BarkingTadpole/Hubba-Hubba-hub-motor-RC/README.md

car go vroom but with 4 hub motors and torque vectoring and maybe self driving eventually
