BarkingTadpole/Hubba-Hubba-hub-motor-RC/tools/esp32_pin_map/esp32_board_minimal.png

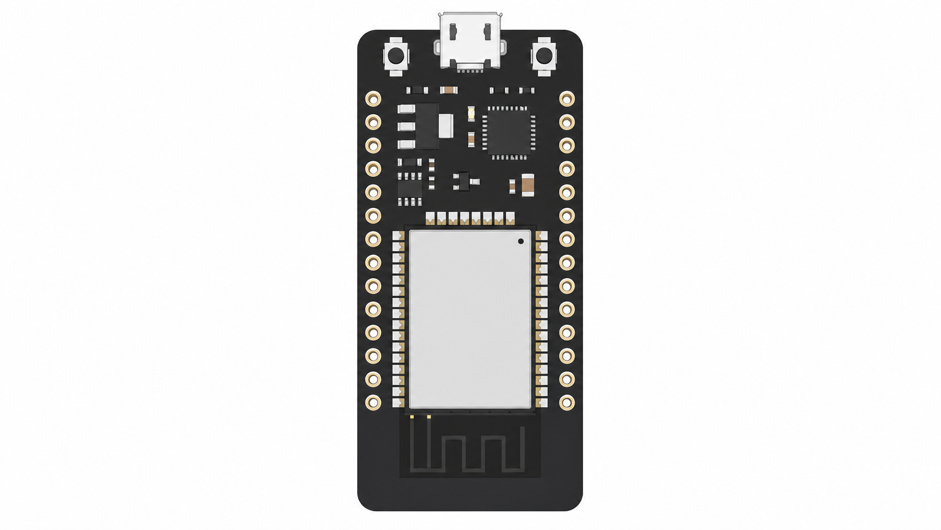
tools/esp32_pin_map/esp32_board_minimal.png
