BarkingTadpole/Hubba-Hubba-hub-motor-RC/rc_car_project_models/V2/attenuators/front_attenuator - front_attenuator.3mf

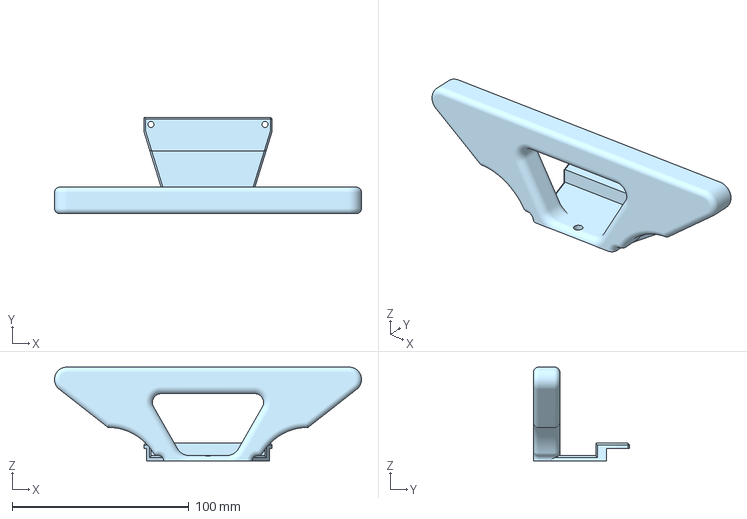
[picture p2: CAD file, 2026-07-19, last stored version]
rc_car_project_models/V2/attenuators/front_attenuator - front_attenuator.3mf
173.5 x 54.4 x 53.0 mm
