BarkingTadpole/Hubba-Hubba-hub-motor-RC/rc_car_project_models/V2/chassis/chassis_3dp_split - mid_body_rear.3mf

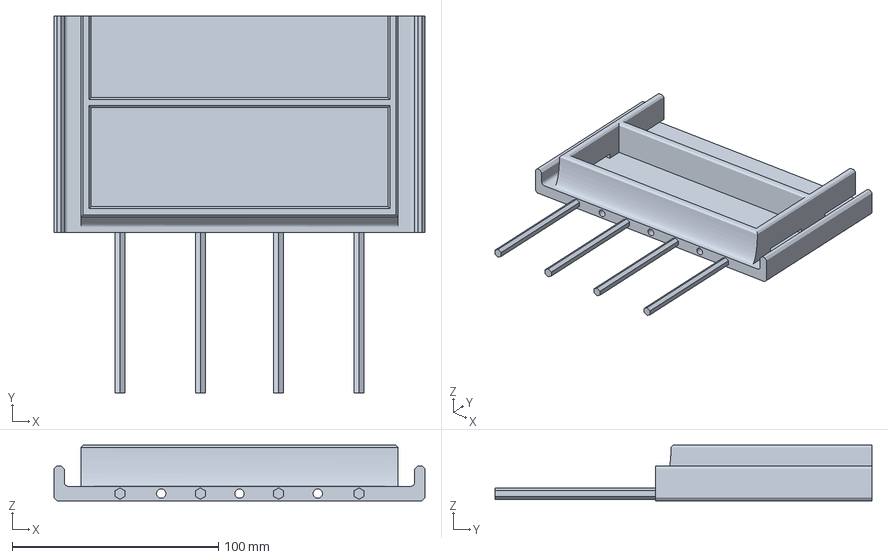
[picture p3: CAD file, 2026-07-19, last stored version]
rc_car_project_models/V2/chassis/chassis_3dp_split - mid_body_rear.3mf
180.0 x 183.0 x 27.0 mm
