BarkingTadpole/Hubba-Hubba-hub-motor-RC/rc_car_project_models/V2/shock_tower+steering+uprights_print.3mf

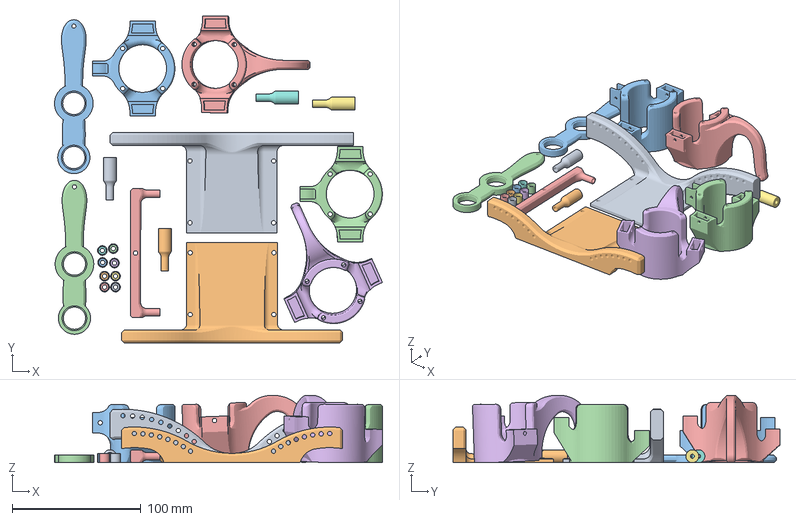
[picture p4: CAD file, 2026-07-19, last stored version]
rc_car_project_models/V2/shock_tower+steering+uprights_print.3mf
254.7 x 253.7 x 52.3 mm
rear_shock_tower
front_shock_tower
rear_left_upright
rear_right_upright
front_left_upright
front_right_upright
end_cap x 8
bellcrank_pivot x 4
bellcrank x 2
drag_link
