BarkingTadpole/Hubba-Hubba-hub-motor-RC/rc_car_project_models/V2/shock_towers/front_shock_tower - front_shock_tower.3mf

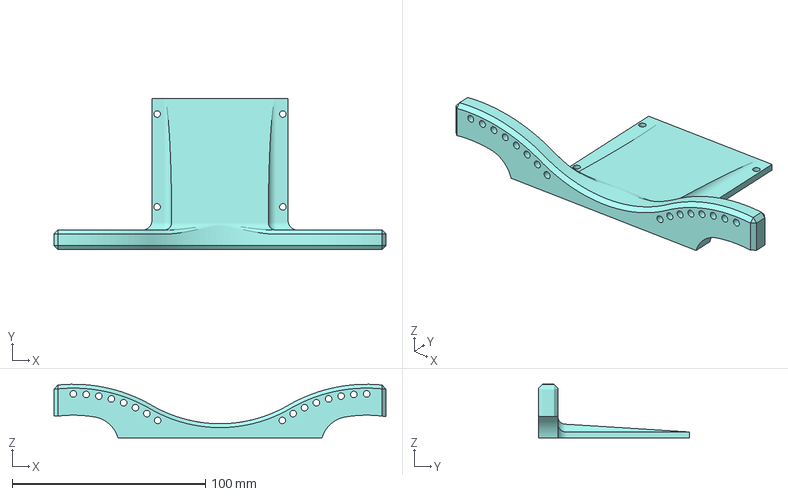
[picture p5: CAD file, 2026-07-19, last stored version]
rc_car_project_models/V2/shock_towers/front_shock_tower - front_shock_tower.3mf
171.6 x 78.0 x 27.7 mm
