BarkingTadpole/Hubba-Hubba-hub-motor-RC/rc_car_project_models/V2/steering/bellcrank - bellcrank.3mf

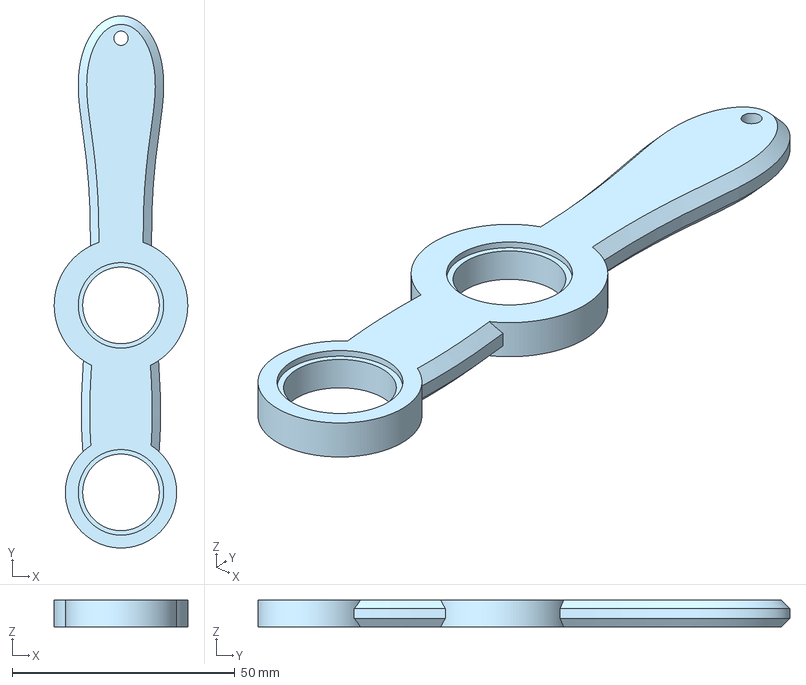
[picture p6: CAD file, 2026-07-19, last stored version]
rc_car_project_models/V2/steering/bellcrank - bellcrank.3mf
30.0 x 119.5 x 6.00 mm
