BarkingTadpole/Hubba-Hubba-hub-motor-RC/rc_car_project_models/V2/uprights/rear_uprights - rear_left_upright.3mf

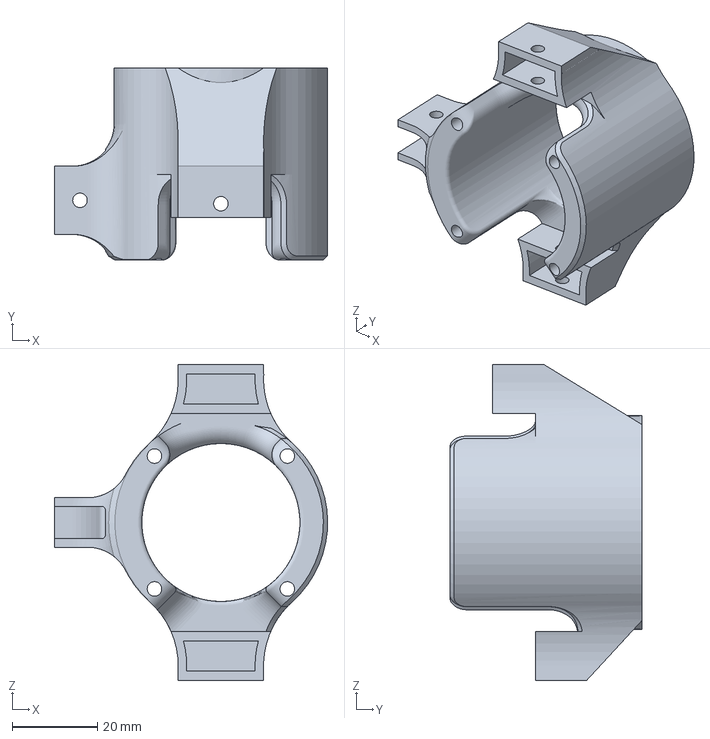
[picture p7: CAD file, 2026-07-19, last stored version]
rc_car_project_models/V2/uprights/rear_uprights - rear_left_upright.3mf
64.0 x 45.0 x 74.0 mm
