BarkingTadpole/Hubba-Hubba-hub-motor-RC/rc_car_project_models/V2/wishbones+spacers/upper_wishbone - upper_wishbone.3mf

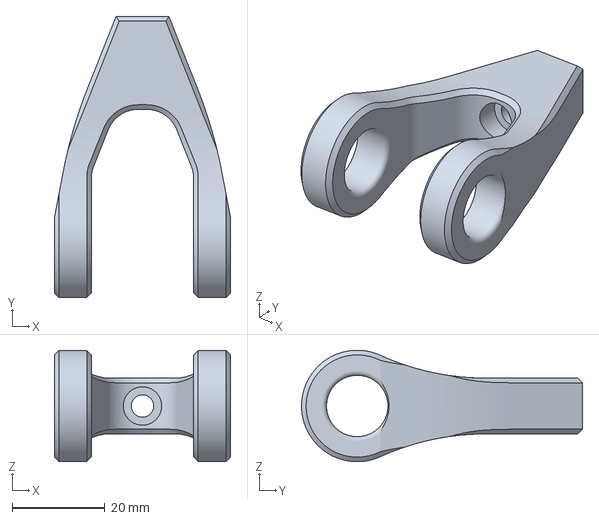
[picture p8: CAD file, 2026-07-19, last stored version]
rc_car_project_models/V2/wishbones+spacers/upper_wishbone - upper_wishbone.3mf
38.0 x 60.5 x 24.0 mm
