BarkingTadpole/Hubba-Hubba-hub-motor-RC/rc_car_project_models/V2/attenuators/rear_attenuator - rear_attenuator.3mf

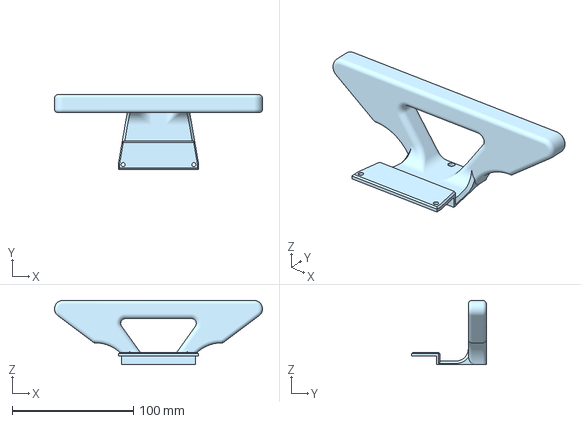
[picture p9: CAD file, 2026-07-19, last stored version]
rc_car_project_models/V2/attenuators/rear_attenuator - rear_attenuator.3mf
171.9 x 61.9 x 53.0 mm
