BarkingTadpole/Hubba-Hubba-hub-motor-RC/rc_car_project_models/V2/shock_towers/rear_shock_tower - rear_shock_tower.3mf

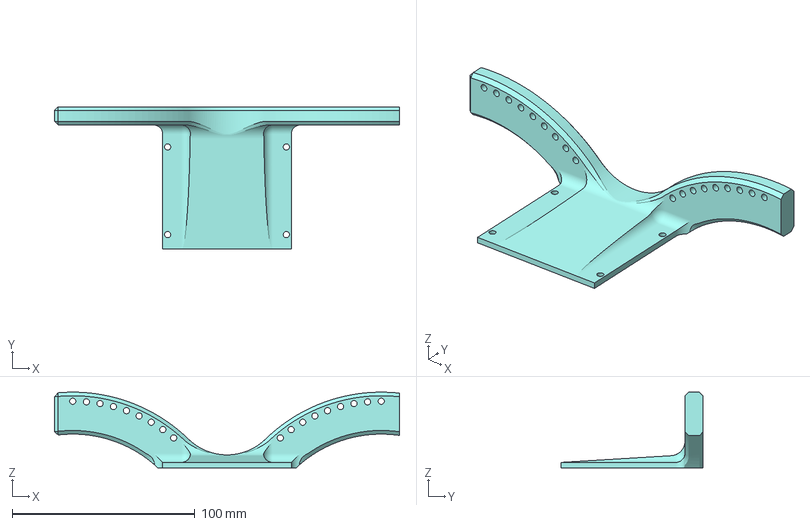
[picture p11: CAD file, 2026-07-19, last stored version]
rc_car_project_models/V2/shock_towers/rear_shock_tower - rear_shock_tower.3mf
189.0 x 78.0 x 41.5 mm
