BarkingTadpole/Hubba-Hubba-hub-motor-RC/rc_car_project_models/V2/steering/end_cap - end_cap.3mf

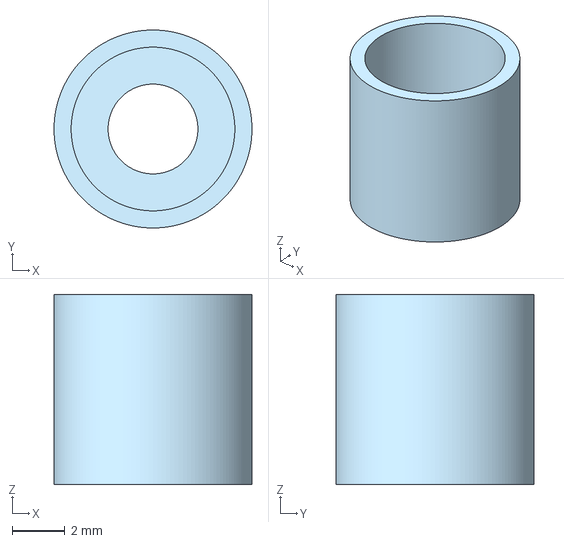
[picture p12: CAD file, 2026-07-19, last stored version]
rc_car_project_models/V2/steering/end_cap - end_cap.3mf
7.50 x 7.50 x 7.20 mm
