BarkingTadpole/Hubba-Hubba-hub-motor-RC/rc_car_project_models/V2/wishbones+spacers/shock_tower_spacer - shock_tower_spacer.3mf

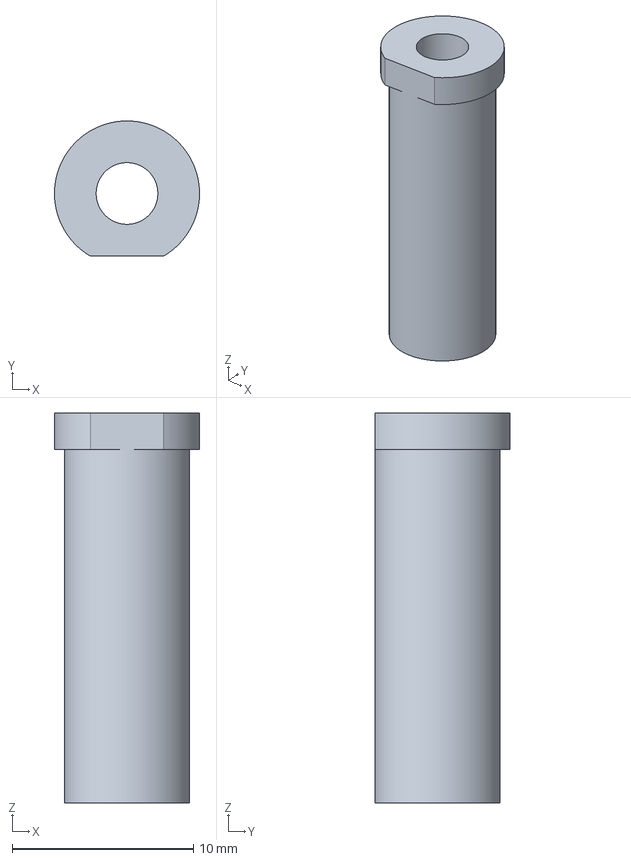
[picture p13: CAD file, 2026-07-19, last stored version]
rc_car_project_models/V2/wishbones+spacers/shock_tower_spacer - shock_tower_spacer.3mf
8.00 x 7.45 x 21.5 mm
