BarkingTadpole/Hubba-Hubba-hub-motor-RC/rc_car_project_models/V2/chassis/bulkhead_print.3mf

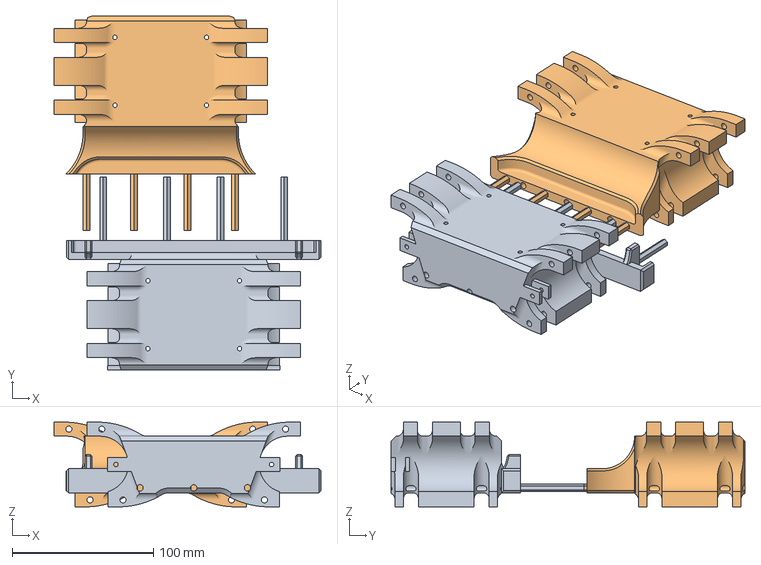
[picture p14: CAD file, 2026-07-19, last stored version]
rc_car_project_models/V2/chassis/bulkhead_print.3mf
188.8 x 250.1 x 60.0 mm
rear_bulkhead
front_bulkhead
