BarkingTadpole/Hubba-Hubba-hub-motor-RC/rc_car_project_models/V2/steering/drag_link - drag_link.3mf

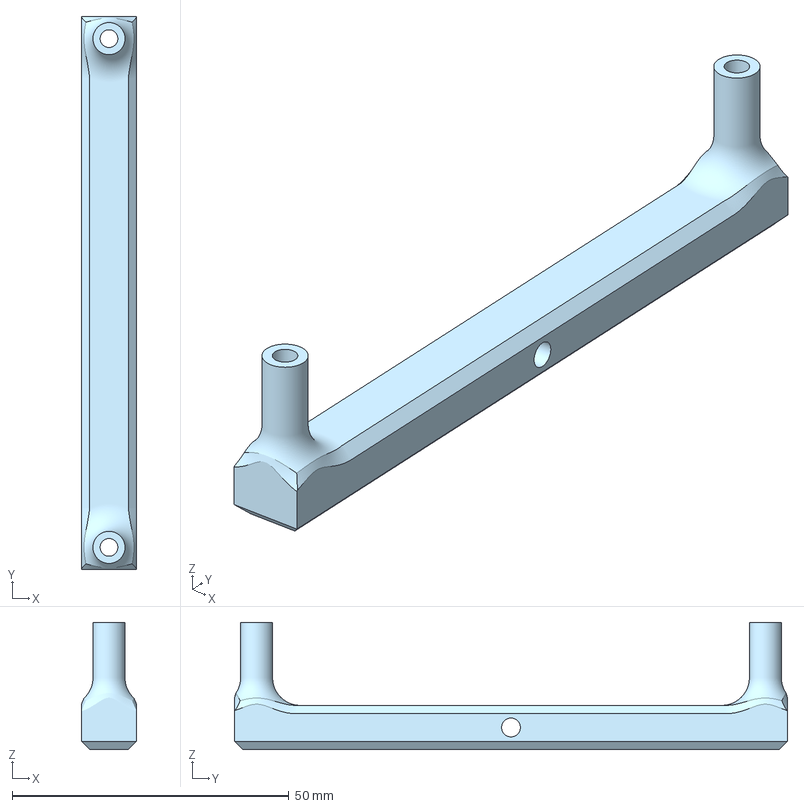
[picture p15: CAD file, 2026-07-19, last stored version]
rc_car_project_models/V2/steering/drag_link - drag_link.3mf
10.0 x 100.0 x 23.0 mm
