BarkingTadpole/Hubba-Hubba-hub-motor-RC/rc_car_project_models/V2/uprights/front_uprights - front_right_upright.3mf

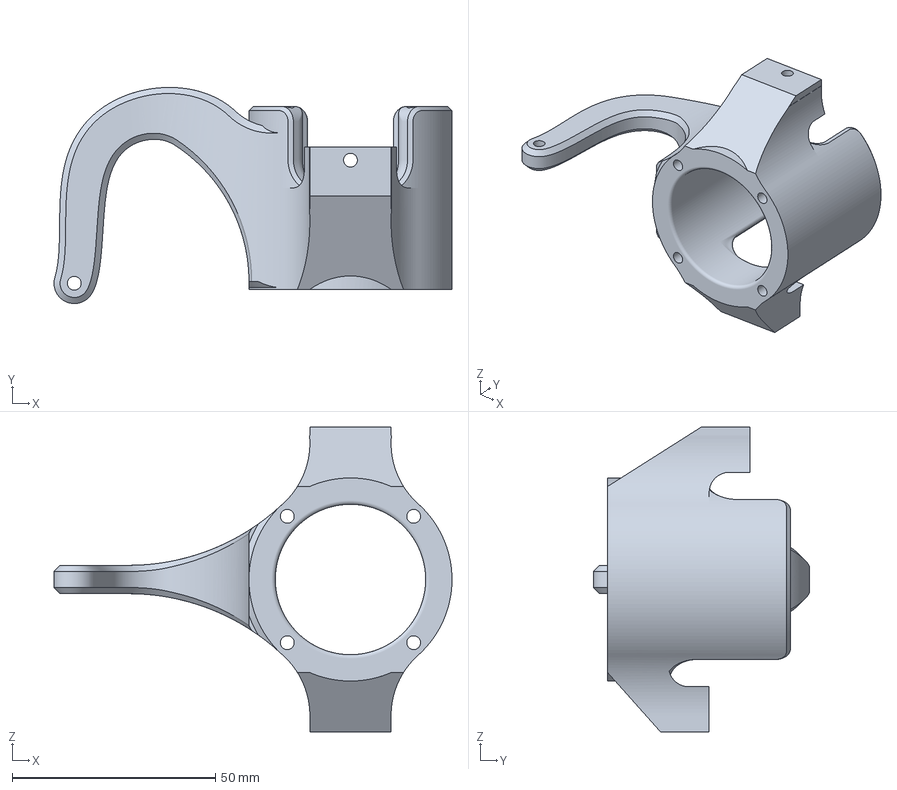
[picture p16: CAD file, 2026-07-19, last stored version]
rc_car_project_models/V2/uprights/front_uprights - front_right_upright.3mf
98.0 x 53.2 x 75.0 mm
