BarkingTadpole/Hubba-Hubba-hub-motor-RC/rc_car_project_models/V2/wishbones+spacers/lower_wishbone - lower_wishbone.3mf

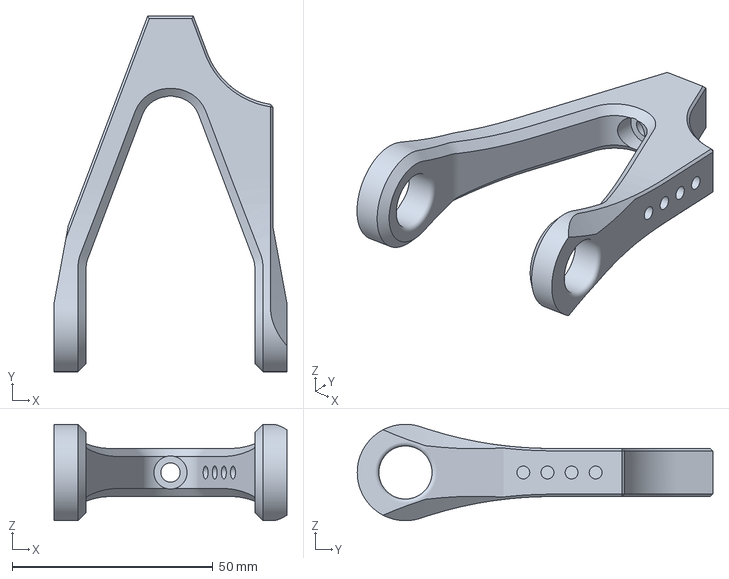
[picture p17: CAD file, 2026-07-19, last stored version]
rc_car_project_models/V2/wishbones+spacers/lower_wishbone - lower_wishbone.3mf
58.0 x 88.5 x 24.0 mm
