BarkingTadpole/Hubba-Hubba-hub-motor-RC/rc_car_project_models/V2/chassis/mid_body_print.3mf

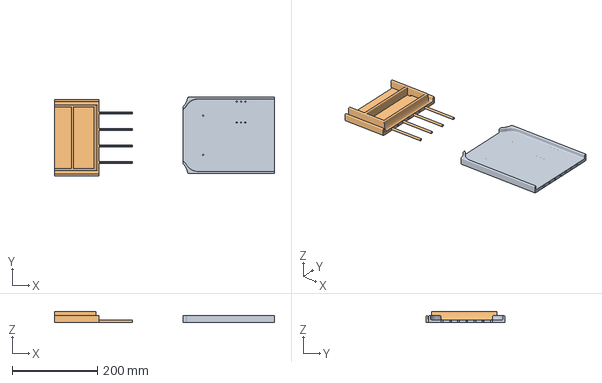
[picture p18: CAD file, 2026-07-19, last stored version]
rc_car_project_models/V2/chassis/mid_body_print.3mf
516.7 x 186.0 x 27.0 mm
mid_body_front
mid_body_rear
