BarkingTadpole/Hubba-Hubba-hub-motor-RC/rc_car_project_models/V2/steering/bell_crank_pivot - bellcrank_pivot.3mf

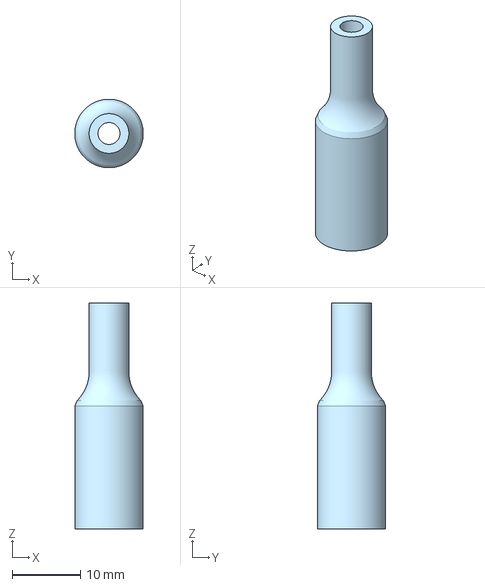
[picture p19: CAD file, 2026-07-19, last stored version]
rc_car_project_models/V2/steering/bell_crank_pivot - bellcrank_pivot.3mf
10.0 x 10.0 x 33.0 mm
