BarkingTadpole/Hubba-Hubba-hub-motor-RC/rc_car_project_models/V2/wishbones+spacers/lower_wishbone_shock_spacer - 35mm_lower_wishbone_shock_spacer.3mf

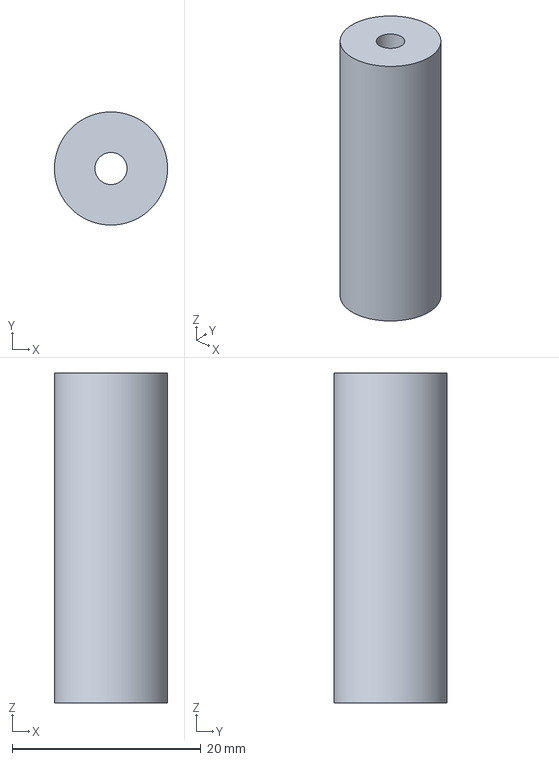
[picture p20: CAD file, 2026-07-19, last stored version]
rc_car_project_models/V2/wishbones+spacers/lower_wishbone_shock_spacer - 35mm_lower_wishbone_shock_spacer.3mf
12.0 x 12.0 x 35.0 mm
