BarkingTadpole/Hubba-Hubba-hub-motor-RC/rc_car_project_models/V2/chassis/chassis_3dp_split - front_bulkhead.3mf

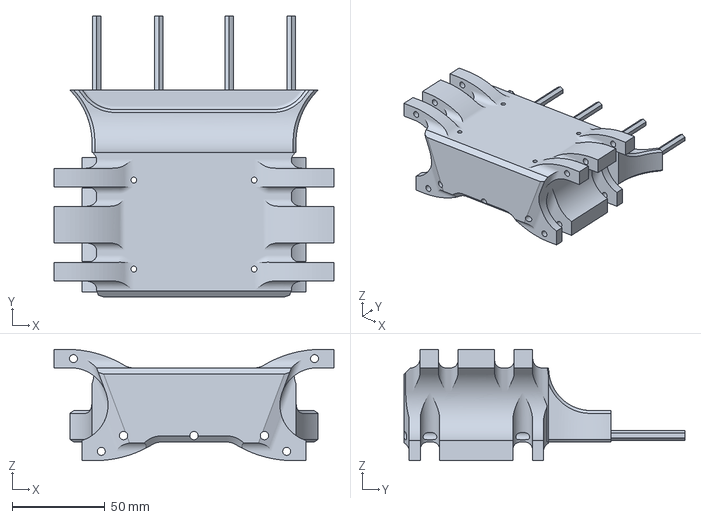
[picture p21: CAD file, 2026-07-19, last stored version]
rc_car_project_models/V2/chassis/chassis_3dp_split - front_bulkhead.3mf
151.0 x 151.5 x 60.0 mm
