BarkingTadpole/Hubba-Hubba-hub-motor-RC/rc_car_project_models/V2/wishbones+spacers/wishbone+spacer_print.3mf

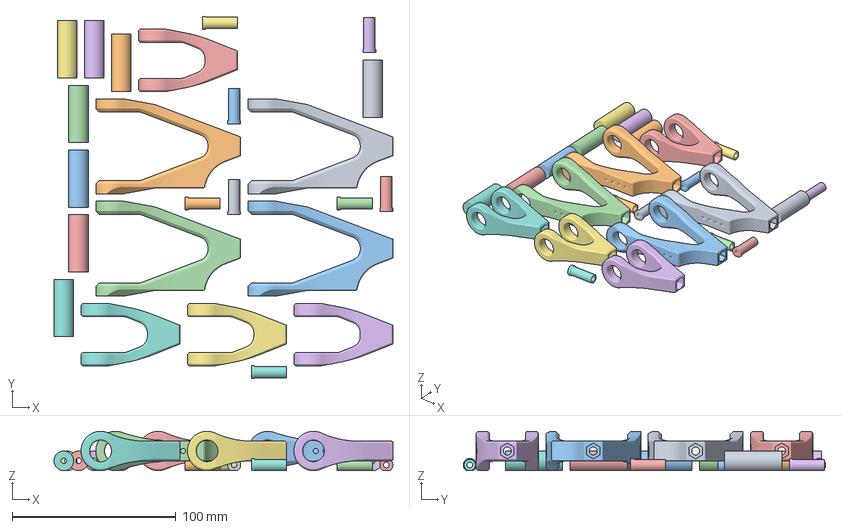
[picture p22: CAD file, 2026-07-19, last stored version]
rc_car_project_models/V2/wishbones+spacers/wishbone+spacer_print.3mf
207.0 x 221.3 x 24.0 mm
lower_wishbone x 4
upper_wishbone x 4
35mm_lower_wishbone_shock_spacer x 8
shock_tower_spacer x 8
