BarkingTadpole/Hubba-Hubba-hub-motor-RC/rc_car_project_models/V2/chassis/chassis_3dp_split - mid_body_front.3mf

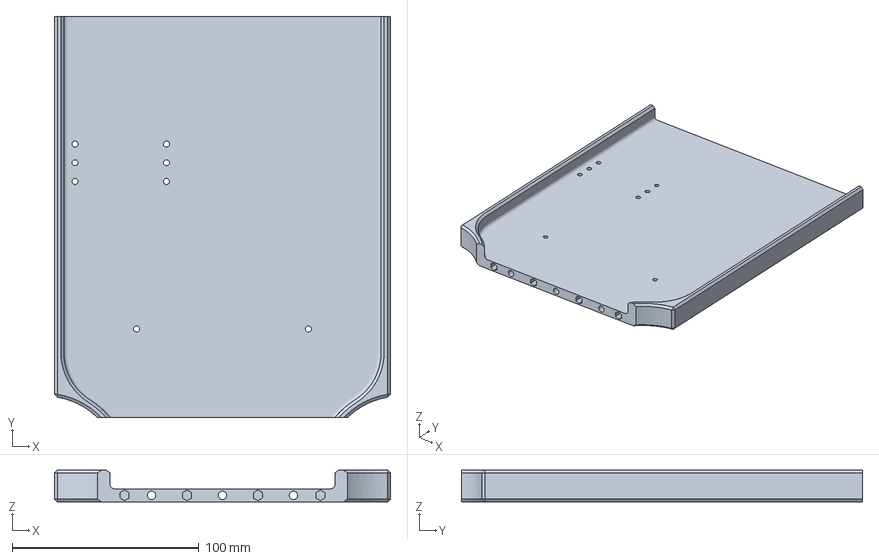
[picture p23: CAD file, 2026-07-19, last stored version]
rc_car_project_models/V2/chassis/chassis_3dp_split - mid_body_front.3mf
180.0 x 215.0 x 17.0 mm
