BarkingTadpole/Hubba-Hubba-hub-motor-RC/(list of files, cad)

Other CAD files:
rc_car_project_models/V2/uprights/rear_uprights - rear_right_upright.3mf
rc_car_project_models/V2/uprights/front_uprights - front_left_upright.3mf
