BarkingTadpole/Hubba-Hubba-hub-motor-RC/main/imu_sensor.c

#include "imu_sensor.h"

#include <math.h>
#include <stddef.h>

#include "driver/i2c_master.h"
#include "esp_timer.h"
#include "freertos/FreeRTOS.h"
#include "freertos/task.h"
#include "sensor_i2c_bus.h"

#define ISM330DHCX_ADDRESS 0x6A
#define ISM330DHCX_WHO_AM_I 0x0F
#define ISM330DHCX_WHO_AM_I_VALUE 0x6B
#define ISM330DHCX_CTRL1_XL 0x10
#define ISM330DHCX_CTRL2_G 0x11
#define ISM330DHCX_CTRL3_C 0x12
#define ISM330DHCX_OUTX_L_G 0x22
#define IMU_STALE_TIMEOUT_US 100000
#define IMU_I2C_TIMEOUT_MS 10
#define IMU_MUTEX_TIMEOUT_MS 5

static i2c_master_dev_handle_t imu_device;
static imu_snapshot_t current_snapshot;
static portMUX_TYPE snapshot_lock = portMUX_INITIALIZER_UNLOCKED;
static float gyro_z_bias_dps;
static int8_t configured_yaw_sign = 1;
static bool initialized;
static bool bias_calibrated;

static int16_t read_i16(const uint8_t *bytes)
{
    return (int16_t)((uint16_t)bytes[0] | ((uint16_t)bytes[1] << 8));
}

static esp_err_t write_register(uint8_t reg, uint8_t value)
{
    uint8_t command[2] = {reg, value};
    return i2c_master_transmit(imu_device, command, sizeof(command), IMU_I2C_TIMEOUT_MS);
}

static esp_err_t read_registers(uint8_t reg, uint8_t *data, size_t data_size)
{
    return i2c_master_transmit_receive(imu_device, &reg, 1, data, data_size,
                                       IMU_I2C_TIMEOUT_MS);
}

static bool read_motion(float gyro_dps[3], float accel_mps2[3])
{
    uint8_t raw[12];

    if (!initialized ||
        !sensor_i2c_bus_lock(IMU_MUTEX_TIMEOUT_MS)) {
        return false;
    }
    esp_err_t err = read_registers(ISM330DHCX_OUTX_L_G, raw, sizeof(raw));
    sensor_i2c_bus_unlock();
    if (err != ESP_OK) {
        return false;
    }

    const float gyro_scale_dps = 0.035f;
    const float accel_scale_mps2 = 0.00478528f;
    for (size_t axis = 0; axis < 3; axis++) {
        gyro_dps[axis] = (float)read_i16(&raw[axis * 2]) * gyro_scale_dps;
        accel_mps2[axis] = (float)read_i16(&raw[6 + axis * 2]) * accel_scale_mps2;
    }
    return true;
}

esp_err_t imu_sensor_init(int8_t yaw_sign)
{
    if (yaw_sign != -1 && yaw_sign != 1) {
        return ESP_ERR_INVALID_ARG;
    }
    configured_yaw_sign = yaw_sign;

    esp_err_t err = sensor_i2c_bus_init();
    if (err != ESP_OK) {
        return err;
    }

    i2c_device_config_t device_config = {
        .dev_addr_length = I2C_ADDR_BIT_LEN_7,
        .device_address = ISM330DHCX_ADDRESS,
        .scl_speed_hz = 400000,
    };
    err = sensor_i2c_bus_add_device(&device_config, &imu_device);
    if (err != ESP_OK) {
        return err;
    }

    uint8_t who_am_i = 0;
    err = read_registers(ISM330DHCX_WHO_AM_I, &who_am_i, 1);
    if (err != ESP_OK) {
        return err;
    }
    if (who_am_i != ISM330DHCX_WHO_AM_I_VALUE) {
        return ESP_ERR_NOT_FOUND;
    }

    err = write_register(ISM330DHCX_CTRL3_C, 0x44);
    if (err == ESP_OK) {
        err = write_register(ISM330DHCX_CTRL1_XL, 0x54);
    }
    if (err == ESP_OK) {
        err = write_register(ISM330DHCX_CTRL2_G, 0x58);
    }
    if (err != ESP_OK) {
        return err;
    }

    initialized = true;
    vTaskDelay(pdMS_TO_TICKS(20));
    return ESP_OK;
}

void imu_sensor_set_yaw_sign(int8_t yaw_sign)
{
    if (yaw_sign == -1 || yaw_sign == 1) {
        portENTER_CRITICAL(&snapshot_lock);
        configured_yaw_sign = yaw_sign;
        portEXIT_CRITICAL(&snapshot_lock);
    }
}

bool imu_sensor_update(void)
{
    float gyro_dps[3];
    float accel_mps2[3];
    int64_t now_us = esp_timer_get_time();

    if (!read_motion(gyro_dps, accel_mps2)) {
        portENTER_CRITICAL(&snapshot_lock);
        if ((now_us - current_snapshot.updated_at_us) > IMU_STALE_TIMEOUT_US) {
            current_snapshot.valid = false;
        }
        portEXIT_CRITICAL(&snapshot_lock);
        return false;
    }

    portENTER_CRITICAL(&snapshot_lock);
    float yaw_bias_dps = gyro_z_bias_dps;
    int8_t yaw_sign = configured_yaw_sign;
    bool calibrated = bias_calibrated;
    portEXIT_CRITICAL(&snapshot_lock);

    gyro_dps[2] -= yaw_bias_dps;

    portENTER_CRITICAL(&snapshot_lock);
    for (size_t axis = 0; axis < 3; axis++) {
        current_snapshot.gyro_dps[axis] = gyro_dps[axis];
        current_snapshot.accel_mps2[axis] = accel_mps2[axis];
    }
    current_snapshot.yaw_rate_dps = gyro_dps[2] * (float)yaw_sign;
    current_snapshot.updated_at_us = now_us;
    current_snapshot.valid = true;
    current_snapshot.bias_calibrated = calibrated;
    portEXIT_CRITICAL(&snapshot_lock);
    return true;
}

bool imu_sensor_calibrate_bias(uint32_t duration_ms)
{
    if (!initialized || duration_ms < 500) {
        return false;
    }

    /* A failed recalibration must not leave an older bias marked as current. */
    portENTER_CRITICAL(&snapshot_lock);
    bias_calibrated = false;
    current_snapshot.bias_calibrated = false;
    portEXIT_CRITICAL(&snapshot_lock);

    double sum = 0.0;
    double sum_squared = 0.0;
    double accel_magnitude_sum = 0.0;
    uint32_t samples = 0;
    int64_t end_at_us = esp_timer_get_time() + ((int64_t)duration_ms * 1000);

    while (esp_timer_get_time() < end_at_us) {
        float gyro_dps[3];
        float accel_mps2[3];
        if (read_motion(gyro_dps, accel_mps2)) {
            double yaw = gyro_dps[2];
            sum += yaw;
            sum_squared += yaw * yaw;
            accel_magnitude_sum += sqrt((double)accel_mps2[0] * accel_mps2[0] +
                                        (double)accel_mps2[1] * accel_mps2[1] +
                                        (double)accel_mps2[2] * accel_mps2[2]);
            samples++;
        }
        vTaskDelay(pdMS_TO_TICKS(5));
    }

    if (samples < 100) {
        return false;
    }

    double mean = sum / samples;
    double variance = (sum_squared / samples) - (mean * mean);
    double accel_magnitude = accel_magnitude_sum / samples;
    if (variance > 9.0 || accel_magnitude < 7.0 || accel_magnitude > 12.5) {
        return false;
    }

    portENTER_CRITICAL(&snapshot_lock);
    gyro_z_bias_dps = (float)mean;
    bias_calibrated = true;
    portEXIT_CRITICAL(&snapshot_lock);
    imu_sensor_update();
    return true;
}

void imu_sensor_get_snapshot(imu_snapshot_t *snapshot)
{
    if (snapshot == NULL) {
        return;
    }

    portENTER_CRITICAL(&snapshot_lock);
    *snapshot = current_snapshot;
    if ((esp_timer_get_time() - snapshot->updated_at_us) > IMU_STALE_TIMEOUT_US) {
        snapshot->valid = false;
    }
    portEXIT_CRITICAL(&snapshot_lock);
}
