BarkingTadpole/Hubba-Hubba-hub-motor-RC/(commit log)

2026-07-19 Init project
    [bell_crank_pivot - bellcrank_pivot.3mf, bellcrank - bellcrank.3mf, bulkhead_print.3mf, chassis_3dp_split - front_bulkhead.3mf, chassis_3dp_split - mid_body_front.3mf, chassis_3dp_split - mid_body_rear.3mf, chassis_3dp_split - rear_bulkhead.3mf, drag_link - drag_link.3mf]
2026-07-31 Refactor codebase and remove obsolete implementation
    [bell_crank_pivot - bellcrank_pivot.3mf, bellcrank - bellcrank.3mf, bulkhead_print.3mf, chassis_3dp_split - front_bulkhead.3mf, chassis_3dp_split - mid_body_front.3mf, chassis_3dp_split - mid_body_rear.3mf, chassis_3dp_split - rear_bulkhead.3mf, drag_link - drag_link.3mf]
2026-08-02 change pin_config.h Added pin visualization feature for harness manufacturing
2026-08-10 added project showcase site, changed pin_config.h, fixed R7FG receiver throttle and switch conflict.
    [cli.c, config_store.c, default_config.h, esc_output.c, generate_pin_map.py, pin_config.h, powertrain_controller.c]
2026-08-18 feat: harden rc car control and steering
2026-08-18 feat: filter steering input across full range
2026-08-19 Added speed based steering curve and cornering control. Added tests for cornering control. Updated torque vectoring to use new steering curve and cornering control.
2026-09-02 Add SoftAP viewer and guarded RC controller calibration workflows
    [partitions.csv]
2026-10-01 trimmed readme
    [BOM.xlsx]
2026-10-01 added VCU dev to .gitignore
    [BOM.xlsx]
